mhendriks/DSMR-API-V1/README.md

# Slimmemeter MQTT interface - DSMR-API
Er zijn al veel DSMR-API/ Slimmemeter / P1 oplossingen in omloop. Toch heb ik besloten om er nog eentje aan toe te voegen omdat veel van de oplossingen niet voldeden aan mijn wensen. Gedachte was de volgende:
- geen voeding nodig (komt uit de slimmemeter)
- meest compacte vorm
- budgetvriendelijk en gebruik maken van een ESP8266/8285 oplossing
- support zowel MQTT als rest json api

## OPLOSSING
Uiteindelijk gekozen voor een ESP-M3 (ESP8285) aangevuld met enkele nog met de hand te solderen SMD componenten.
Op het printje zitten de volgende modules:
- signaal inverter om het P1 signaal te inverteren
- optocoupler voor het aansturen van de P1 (data request)
- spanningsregulator voor het naar 3.3Volt brengen van de P1 spanning.
- de ESP-M3 natuurlijk

Alle modules samen zie je hieronder.
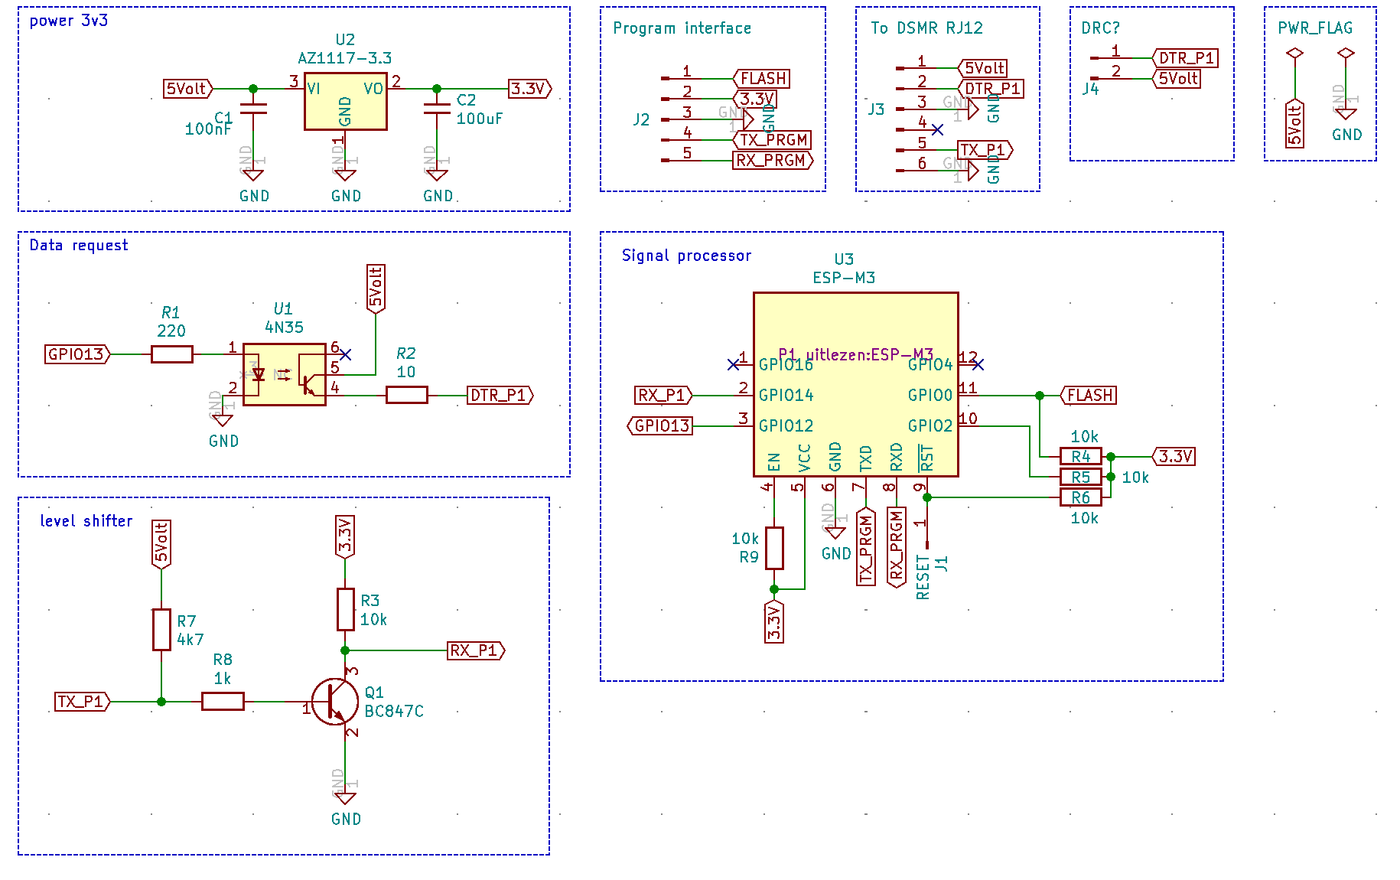
[picture p1: hardware/v1-kicad-schema.png]
Kicad schema
 

modificatie: R5 niet plaatsen aangezien GPIO2 al met een pullup aan de LED zit.

Omgezet naar een board ziet dit er zo uit:
Bovenkant             |  Onderkant |  Eindresultaat
:-------------------------:|:-------------------------:|:-------------------------:
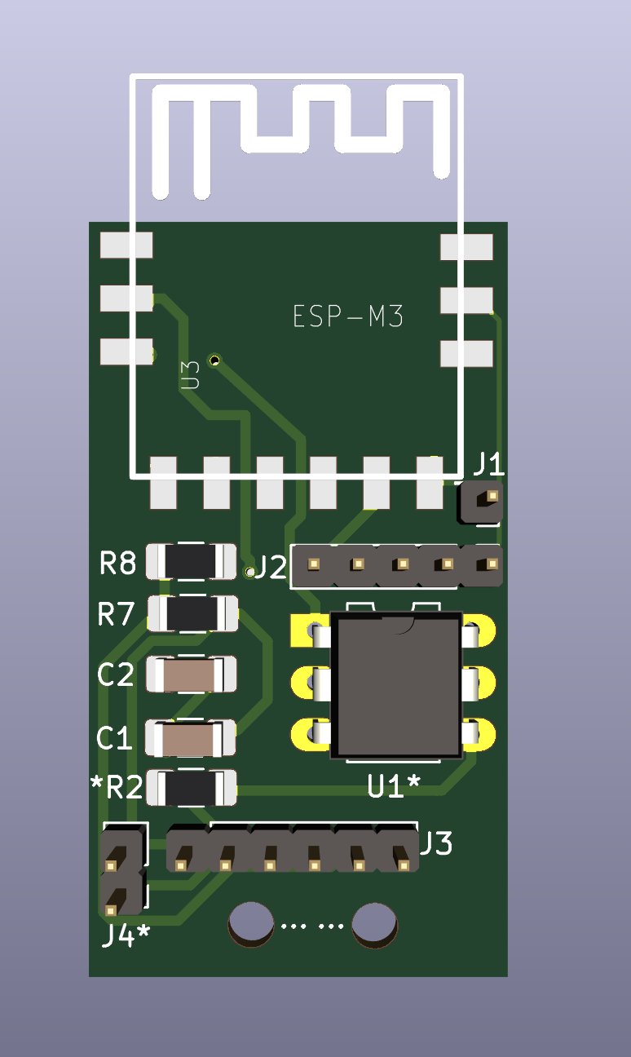
[picture p2: hardware/v1-print-boven.png]
hardware bovenkant
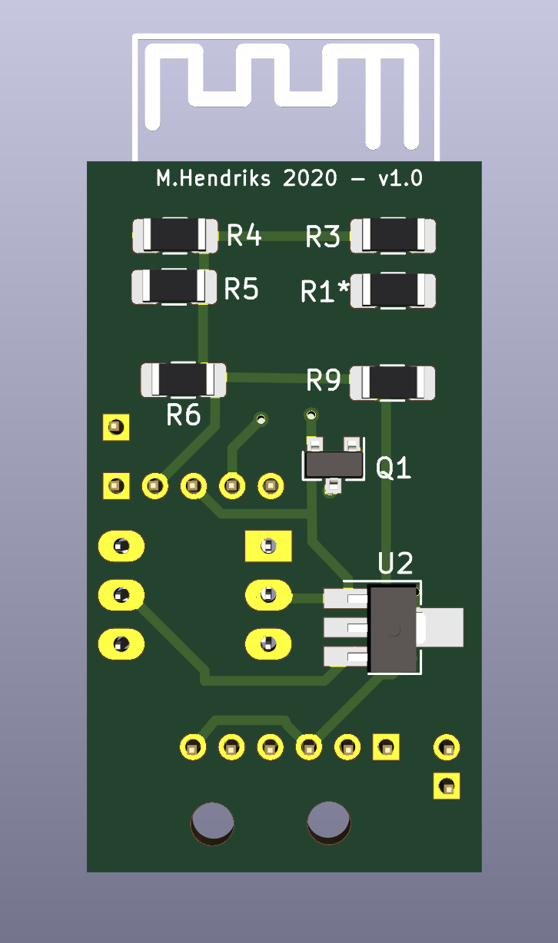
[picture p3: hardware/v1-print-onder.png]
hardware onderkant
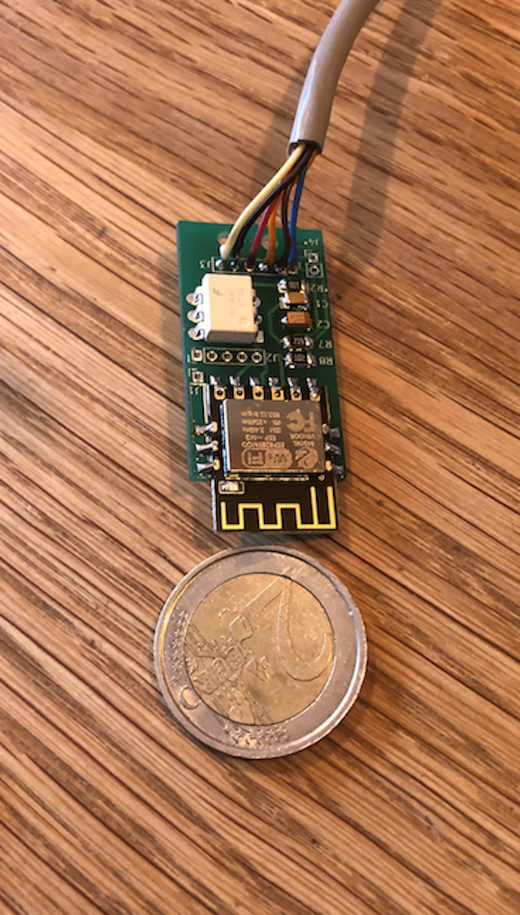
[picture p4: hardware/v1-eindresultaat.png]
hardware foto
  |   | 

Afmeting van de print is 20 x 37mm

## SOFTWARE
Er is veel software online te vinden. Keuze voor de gebruiker vind ik belangrijk daarom gekozen voor twee scenario's, namelijk:
- Tasmota Out of the box (MQTT)
- Json API + User interface (Willem AandeWiel REST-API oplossing)

### Tasmota
Zelf ben ik een groot fan van de Tasmota software voor de ESP8266 familie. Deze is dan ook als eerste gebruikt om de oplossing werkend te krijgen. Tasmota kan out of the box op de module geflasht worden. Instructie is te vinden in de [Tasmota](Tasmota) folder.

### REST-API DSMR Logger van Willem AandeWiel
Veel dank aan Willem AandeWiel voor zijn oplossing. Deze oplossing is als basis genomen en diverse veranderingen aan doorgevoerd. Oplossing van Willem is gemaakt voor een 4MB esp module en de M3 heeft er maar 1. Meer dan genoeg als alle extra functionaliteit verwijderd wordt en de overige compacter wordt gemaakt.
Aanpassingen zijn:
- omdat de ESP-M3 geen secundaire seriele interface heeft die te gebruiken is is er een software oplossing gebruikt (met dank aan Tasmota); In de basis is de oplossing van Willem te gebruiken met een kleine aanpassing voor deze seriele interface.
- alle statische pagina's komen uit een CDN (esp modules hebben maar een beperkte capaciteit en zijn geen hele goede webservers;)
- alle plaatjes zijn nu iconen geworden, ook van cdn
- files zijn omgezet naar Json zodat dit makkelijk te onderhouden is en compacter wordt
- json API communicatie is ook gewijzigd (compacter en als een burst ipv gesegmenteerd)
- opmaak is zo veel als mogelijk uit de html / js files gehaald en in de css gestopt (overigens nog niet af)

## Domotica integratie
voorbeelden van integratie zijn te vinden in de folder [Integratie](Integratie). Het gaat om koppeling met:
- Home Assistant
- OpenHab
- Domoticz
